karthik-m-11/Reaction-Wheel-Attitude-Control-System-in-CubeSats/live simulation/result.png

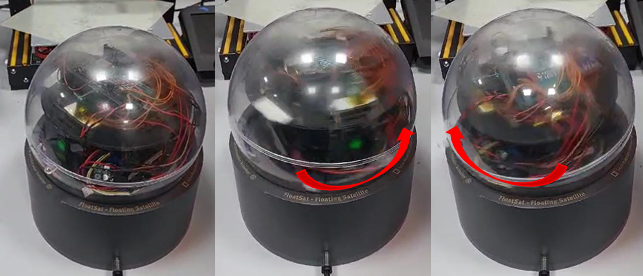
live simulation/result.png
