karthik-m-11/Reaction-Wheel-Attitude-Control-System-in-CubeSats/hardware/schematic implementation.png

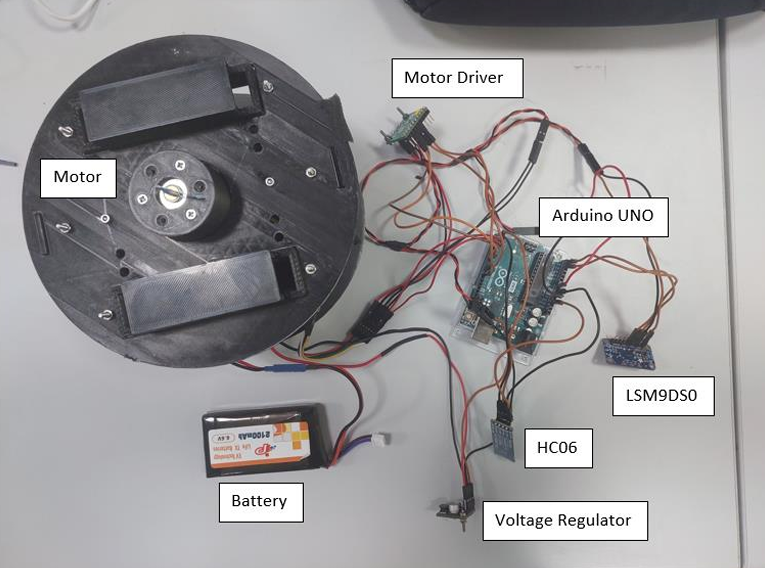
hardware/schematic implementation.png
