karthik-m-11/Reaction-Wheel-Attitude-Control-System-in-CubeSats/hardware/schematic top.png

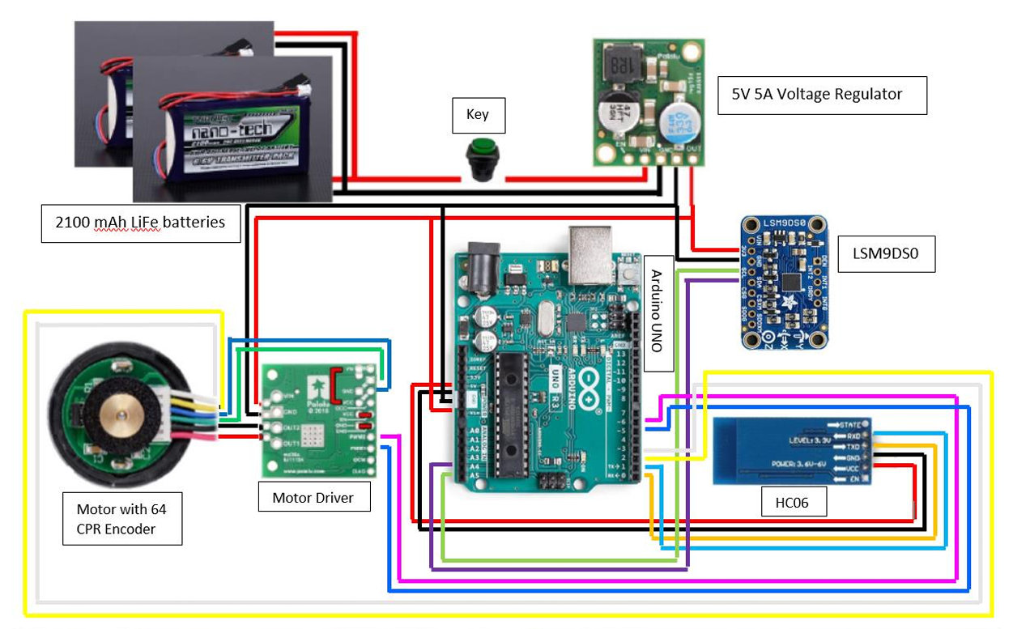
hardware/schematic top.png
