karthik-m-11/Reaction-Wheel-Attitude-Control-System-in-CubeSats/hardware/schematic setup.png

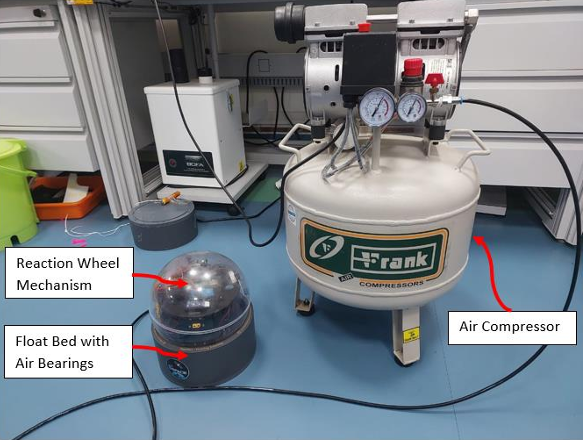
hardware/schematic setup.png
